willblev/Slack_two_button_traffic_light/(commit log)

2022-02-06 initializing with current state
2022-02-07 changed button pins to be defined
